osptek/devboard-esp32p4c6_module/images/board-front_en.png

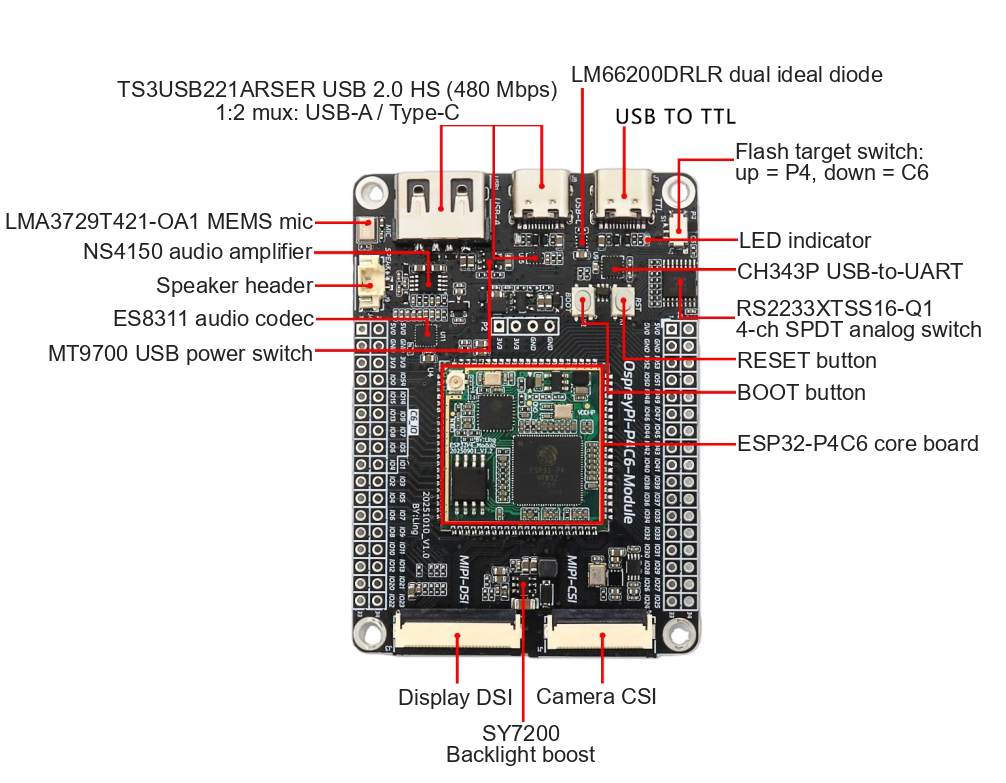
images/board-front_en.png
