osptek/devboard-esp32p4c6_module/docs/ESP32-P4C6-Module_PoE-Ethernet-Adapter_V1.2.step

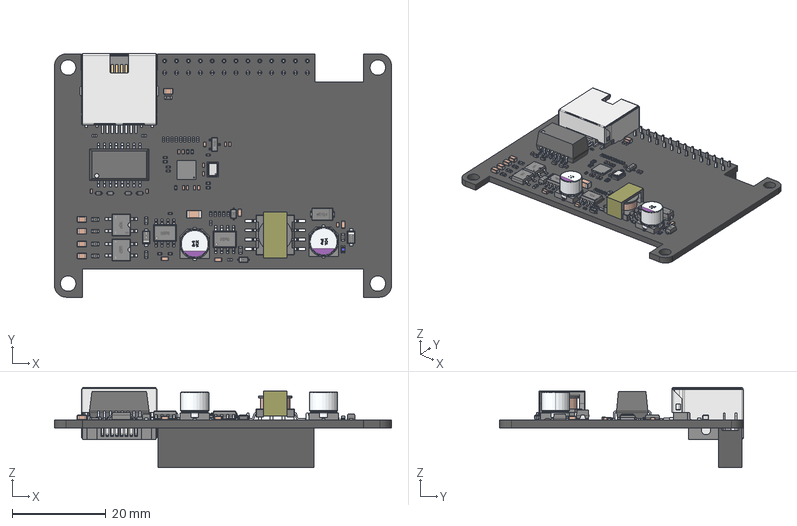
[picture p10: CAD file, 2026-11-06]
docs/ESP32-P4C6-Module_PoE-Ethernet-Adapter_V1.2.step
72.0 x 52.0 x 17.1 mm
SOD123F x 2
0805-c x 5
coileasy:SMD-8P, 11.55x9.6, ER9.5 4+4~ER9.5-SMD_3D~Z9m3
coileasy:SMD-8P, 11.55x9.6, ER9.5 4+4~ER9.5-SMD_3D~Z9m3 (1)
coileasy:SMD-8P, 11.55x9.6, ER9.5 4+4~ER9.5-SMD_3D~Z9m3 (2)
coileasy:SMD-8P, 11.55x9.6, ER9.5 4+4~ER9.5-SMD_3D~Z9m3 (3)
Female-Header-2.54-Double-26
OSC_EPSON_SG-310
SOT23-3
SOT23-3 ӽ½À x 3
LOGOԲ0.15
SOP8_̜ͥ x 2
ºñ¶È1.8_µÄÒý½Å_5 x 16
TQFN-32_4x4mm_0.4
SMD-16_L12.7-W6.7-P1.27-LS9.4-BL~SMD-16_ L12.7-W6.7-P1.27-LS9.4-BL~Gcb W
Mid_Body x 31
Mark x 31
SOD323 x 2
0603-ledb
SMA
LOGOԲ££°.£³
MBF_1 x 2
SOD-523 x 4
LOGOԲ££°.£±£µ x 4
0402-c x 14
0603c x 4
LOGOԲ x 2
CT 6X6-V x 2
1206-c
RJ45-TH_RC01812~RJ45-TH_RC01812~UJNY
RJ45-TH_RC01812~RJ45-TH_RC01812~UJNY (1)
