osptek/devboard-esp32p4c6_module/docs/ESP32-P4C6-Module_Schematic_V1.5.pdf

Size A4 | Ver. 1.5 | Author Ling
Sheet 1 / 1 | | Data 2026/08/28
