osptek/devboard-esp32p4c6_module/docs/ESP32-P4C6-Module_PoE-Ethernet-Adapter_Schematic_V1.2.pdf

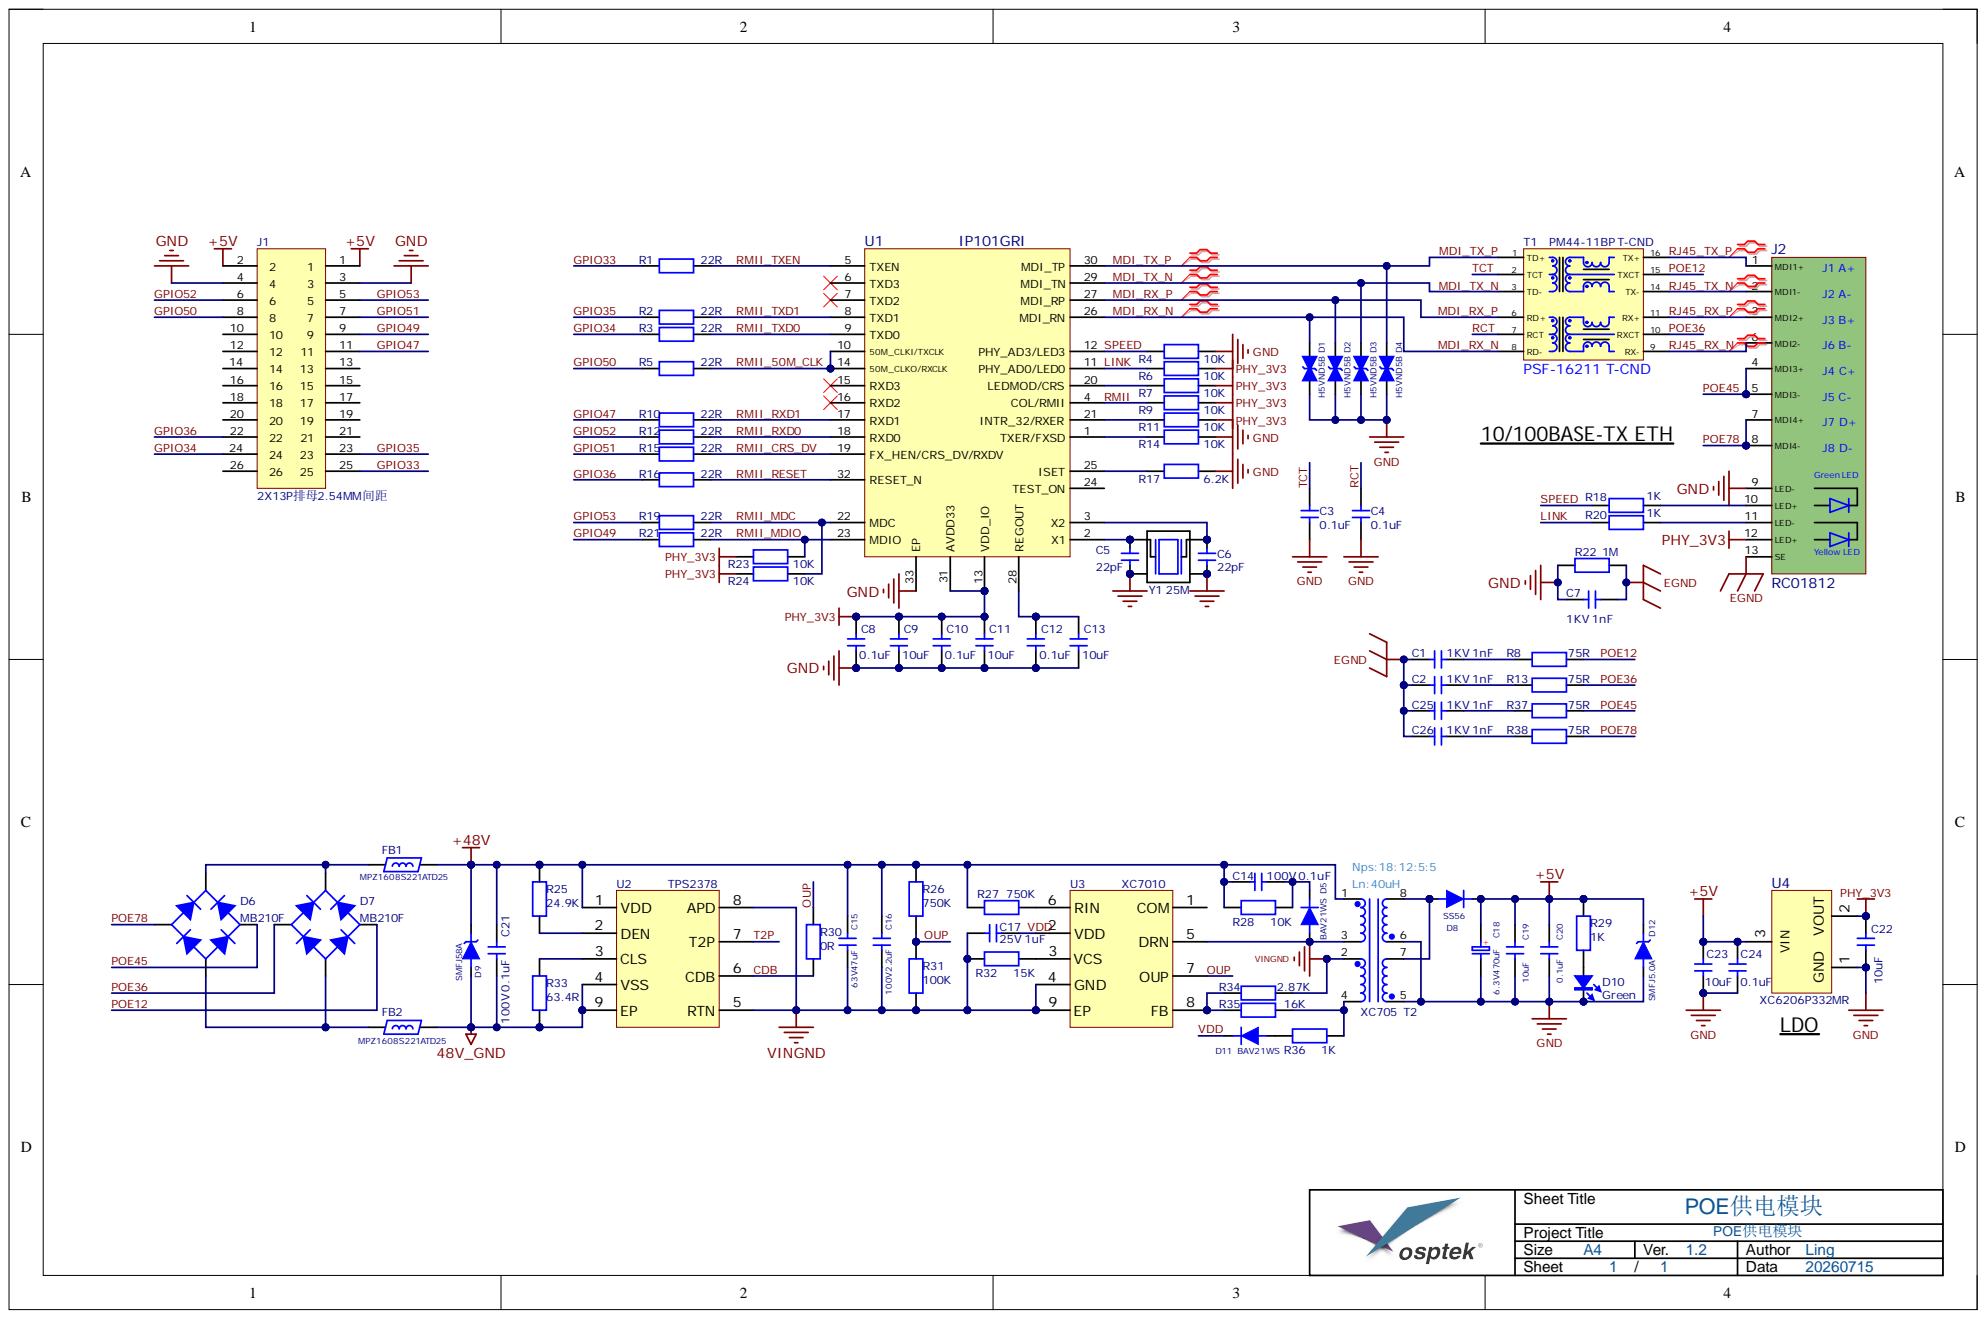
[picture p16: page 1]

TXD3 6 | MDI_TX_N | TCT
TXD2 7 | | | MDI_TX_N

Size A4 | Ver. 1.2 | Author Ling
Sheet 1 / 1 | | Data 20260715
