osptek/devboard-esp32p4c6_module/(commit log)

2026-11-05 docs: initial release of ESP32-P4C6-Module dev board
    - Product README in Chinese and English
    - User guide, product manual, schematic V1.3
    - Camera, antenna, SC2336 and speaker datasheets
    - ESP32-C6 ESP-Hosted v2.12.9 co-processor firmware (flash C6 @ 0x0)
    - Front/back callout and dimension images (CN/EN)
    - Licensed under CC BY-NC-SA 4.0
2026-11-06 docs: add PoE Ethernet adapter board V1.2
    - Schematic PDF and PCBA STEP model
    - 3D render and dimension images
    - README (CN/EN): adapter specs and RMII pin mapping
    [ESP32-P4C6-Module_PoE-Ethernet-Adapter_V1.2.step]
2026-11-13 docs: update carrier schematic to V1.5
